yuheng-null/stm32-smart-fan/Core/Inc/main.h

#define KEY1_Pin GPIO_PIN_0
#define KEY1_GPIO_Port GPIOC
#define KEY2_Pin GPIO_PIN_1
#define KEY2_GPIO_Port GPIOC
#define FAN_TACH_Pin GPIO_PIN_1
#define FAN_TACH_GPIO_Port GPIOA
#define RELAY_IN_Pin GPIO_PIN_0
#define RELAY_IN_GPIO_Port GPIOB
#define BUZZER_IO_Pin GPIO_PIN_1
#define BUZZER_IO_GPIO_Port GPIOB
#define IR_RX_Pin GPIO_PIN_7
#define IR_RX_GPIO_Port GPIOC
#define IR_RX_EXTI_IRQn EXTI9_5_IRQn
#define FAN_PWM_Pin GPIO_PIN_8
#define FAN_PWM_GPIO_Port GPIOA
#define OLED_SCL_Pin GPIO_PIN_6
#define OLED_SCL_GPIO_Port GPIOB
#define OLED_SDA_Pin GPIO_PIN_7
#define OLED_SDA_GPIO_Port GPIOB
