yuheng-null/stm32-smart-fan/(commit log)

2026-10-10 STM32F407VET6 智能温控风扇：HAL 工程骨架与串口链路
    - CubeMX 生成的 CMake 工程（Core/ + Drivers/ + cmake/）
    - 时钟：8 MHz HSE → 168 MHz（PLLM=8 / PLLN=336 / PLLP=2 / PLLQ=7，APB1=/4，APB2=/2）
    - 调试：SWD（PA13/PA14）
    - USART1 115200-8-N-1（PA9=TX / PA10=RX），接 CH340
    - 分层骨架：interface/（契约）→ bsp/（实现）→ app/（编排）
    - 串口接收走中断 + 256 字节环形缓冲，实测连续 512 字节背靠背收发不丢
    - 配置改动走 cube-recipes/ 配方 + tools/cubemx_apply.py 驱动 CubeMX 脚本模式
    - tools/capture_serial.py：抓串口输出并测量心跳间隔（用于实测主频）
    - docs/：架构说明 + 从空文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
2026-10-11 三路外设驱动：SSD1306(软 I2C) / NTC 测温(ADC) / 按键；新增 driver 层
    ## 新增
    - driver/ 层：`bus/`（软件 I2C 位翻转实现）+ `device/`（SSD1306 驱动，
    不含任何 STM32 符号）。契约集中在 interface/（新增 i2c_if.h），
    bsp/ 只负责「这块板上谁接在哪」。
    - bsp/bsp_i2c.c PB6=SCL / PB7=SDA，开漏输出 + 上拉
    - bsp/bsp_oled.c SSD1306 绑定、0x3C/0x3D 地址探测、总线扫描
    - bsp/bsp_key.c PC0/PC1，SysTick 1 ms 采样 + 20 ms 计数式消抖
    - bsp/bsp_adc.c PA0 / ADC1_IN0
    - module/temperature/ NTC 分压 -> Beta 方程 -> 毫摄氏度。纯计算，
    不碰硬件，可脱离板子在 PC 上单测。
    - app/app_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
2026-10-11 工程工具加 regenerate 子命令；补齐文档里"生成代码"这一步
    ## 为什么
    `tools/cubemx_apply.py apply` 只改 `.ioc`、**不生成代码**，而"生成"这步此前
    只有文档里那条手写 `.mxscript` 的路子。补上之后，改配置的完整流程都在工具内：
    apply → roundtrip → regenerate
    `regenerate` 做的事：给 `Core/` 下所有 USER CODE 块拍快照（并把整个 `Core/`
    备份到临时目录）→ 跑 CubeMX 生成 → 逐块比对 → 再比对 `Core/` 下文件的**内容**。
    USER CODE 丢失/被改写、或有文件被删掉，都返回非 0 并打印备份路径。
    ## 两个坑（都写进了 walkthrough 阶段 12.4）
    第一版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
2026-10-11 三路新驱动：风扇 PWM 调速/FG 测速 + 继电器 + 蜂鸣器
    驱动
    - bsp/bsp_fan：TIM1_CH1 出 25 kHz PWM（开漏驱动，高电平靠风扇内部上拉建立），
    TIM2_CH2 输入捕获测 FG 周期。ISR 只做一次读寄存器 + 一次减法，
    单位换算与转速计算留给主上下文
    - module/fan_control：FG 周期 → 转速、占空比步进（纯计算，无硬件依赖，可在 PC 上单测）
    - bsp/bsp_relay（PB0，高电平触发）/ bsp/bsp_buzzer（PB1，低电平触发）：
    初始电平的唯一来源是 .ioc 的 PinState，驱动侧不再写第二遍
    - app：K1/K2 加减档；串口单字符命令 ? + - r b t；状态行与 OLED 加风扇/继电器/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
2026-10-11 温控业务层：级联控制 + 运行模式状态机 + 宿主机单测与 CI
    ## 新增（module/，全部纯计算，可在 PC 上单测）
    - common/ 共享值类型（采样快照、模式、报警位），只有头文件
    - fan_curve/ 温度 -> 目标转速：分段线性插值 + 施密特迟滞，整数域
    - pi_control/ 通用 PI：条件积分抗饱和 + 限幅 + 限速率，无 D 项
    - thermal_control/ 级联控制器 = fan_curve + pi_control 的组合
    （EMA 抑噪、传感器去抖、温度兜底、FG 失效切开环前馈、无扰切换）
    - fan_fsm/ 运行模式状态机（INIT/OFF/MANUAL/AUTO/DEGRADED/FAULT）
    - console/ 串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
2026-10-11 上板实测修复三处，并按实测 τ 重整定内环 PI
    烧录后跑验收，抓到三个只有硬件才能暴露的问题，外加一次整定事故。
    ## 修复
    1. !TACH 误报
    温度低于曲线起点时风扇本就该停转，FG 自然没有沿，却被判成「丢信号」，
    系统一直挂在 DEGRADED + !TACH 这个假故障上。
    改为两条前提：只有**确实要求它转**（目标转速 > 0）时缺反馈才算故障；
    且只有 ERR_TIMEOUT / ERR_UNDERFLOW 算「信号断了」的证据，
    ERR_NOT_READY（刚起转、还没凑够两个沿）与 ERR_OVERFLOW（毛刺）是瞬态，
    把它们也算进去会让风扇每次启动都凭空报一次故障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
2026-10-11 README 重写：补齐「功能与现象」，按模式/命令/报警/故障逐条写明现象
    原来的 README 讲的是「怎么编译、怎么验证」，但没讲清**这东西到底做什么、
    每种情况下会看到什么**。补上一整节，按读者会问的顺序组织：
    - 一句话说明 + 五块功能分别落在哪个模块
    - **上电后头几秒会看到什么**（含「刚烧录过会看到转速滑停」这个容易被当成
    故障的现象）
    - **六种运行模式**：每一种在 风扇/报警灯/蜂鸣器/OLED/串口 五处分别是什么现象，
    以及为什么报警灯亮在 FAULT 而不是过温（冷却风机故障应满速，不能断电）
    - **按键**：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
2026-10-11 CI：actions/checkout 升到 v5，消掉 Node 20 弃用提醒
    首次运行的输出里有 GitHub 的弃用注解（v4 目标是 Node 20，被强制跑在
    Node 24 上）。升到 v5 之后 CI 输出干净，不会让人误以为有什么问题。
2026-10-11 README 补上实测波形与可复现工具
    ## 新增「实测结果」一节
    嵌入两张**板上实测**的图（数据来自 @TEL 遥测帧，不是示意图）：
    - 阶跃辨识：MANUAL 20 → 60，按 63% 规则得 **τ ≈ 1.4 s**
    （三次独立测量 1.39 / 1.41 / 1.39 s，可复现）
    - 闭环跟踪：从 MANUAL 切进 AUTO，约 10 s 收敛；
    **稳态偏差落在一个占空比量化台阶以内**（1% duty ≈ 163 rpm，
    在 5300 rpm 上是 3%，多次实测 1.5%~2.4%）
    这两张图是整篇文档里最有说服力的部分——它们把「这套控制真的在工作」
    从文字变成了数据。
    ## 新增 tools/fan_demo.py
    一条命令重现上面两张图：自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
2026-10-11 业务层：修温度非对称去抖、EMA 陈旧值，补两条回归测试
    温度兜底的两个方向共用了进入阈值：进入要连续 3 拍无效、退出本该连续 5 拍
    有效，但退出实际在第 3 拍就发生，recovery_debounce_samples 与退出时的曲线
    迟滞复位都成了不可达代码。改为按当前认定的方向选阈值，退出挂在下沿上。
    顺带几处控制层的边界：
    - 转速无效期间清掉 EMA 标志，恢复后的第一个样本直接采信，不再把断线前的
    陈旧读数按 (1-alpha) 混进来喂给 PI
    - PI 挡住 NaN 的误差：clampf 对 NaN 会原样返回，一旦进入就永久污染状态
    - thermal_control_init 抬高 PI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
2026-10-11 应用层与 BSP：显示改走 BSP 契约，启动不再被串口门控
    分层：app_display.c 原先直接 include driver/device/ssd1306 并自己持有设备
    实例，等于把外设驱动放进了 APP 层，与 docs/architecture.md 的依赖表不符。
    改成 BSP 透出一组与器件无关的绘制接口（清屏 / 画字 / 量字宽 / 上屏），
    ssd1306_t 与显存实例都收进 bsp_oled.c；APP 层不再认识 SSD1306。
    启动：原先开机横幅发不出去就 continue，串口 TX 一出问题主循环永远停在横幅
    那一步，温控、按键、报警灯、蜂鸣器全都不工作。改成横幅只发一次、失败也不
    挡后面的任务——诊断链路坏掉不该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
2026-10-11 文档与代码对齐，并把标定内容按「能力」叙述
    与代码对不上的地方逐条改到一致：
    - docs/control.md 的曲线锚点表刷新为当前值（30C/3500 ... 60C/13500），
    并说明低端为什么从最小可控转速起步
    - 整定算式：lambda 的单位是秒。按 lambda = 2.5 s 代入才得到发布的
    0.0034 / 0.0025（反解 lambda = tau/(K*Kp) 约 2.53 s），原表把
    lambda 标成 tau 的倍数、代入的却是秒
    - docs/walkthrough.md 的波特率分频算式补成完整两步（商约 45.573，
    取整到 4 位小数的 USARTDIV = 729/16 = 45.5625）
    - 中断优先级一段改为描述实际分配：USART1 = 2、TIM2 捕获 = 3，
    并说明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
2026-10-11 红外遥控：NEC 解码模块 + EXTI 接线 + 按键表与学习模式
    接一个 VS1838B（OUT → PC7），用任意 NEC 遥控器控制风扇。
    解码做成纯计算的独立模块（module/ir_remote）：输入是「边沿 + 这个电平持续了
    多久」，输出是一帧或一次拒绝。不含 HAL、不看引脚，所以能在 PC 上用合成波形
    穷举测试（tests/test_ir_remote.c，20 个用例）。红外一次误码要在整帧 32 位里
    定位到具体哪一位，在板子上几乎做不到；合成波形既能测正常帧，也能故意把某段
    拉偏、丢一个沿、改一位，逐条核对解码器是不是按预期失败。
    解码器上有几处是刻意这么写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
2026-10-11 文档：补上红外遥控一节与接线说明
    README 增加「四、红外遥控：按键与现象」——默认键位表、按住不放的行为、
    以及换遥控器不用改代码的做法（IR LEARN 1 读码，把那行抄进 s_bindings[]）；
    后面几节顺延编号。另补上：功能块表、硬件表、串口命令表、测试表、
    上电现象与验收清单各加一条，目录结构加上 module/ir_remote。
    docs/hardware.md 补「红外接收头」一节：三针接线、引脚顺序按丝印核对
    （没有防反接，接错等于把 VCC 灌进 OUT）、为什么是解调式输出、
    为什么用 EXTI 而不是输入捕获、上拉与中断优先级的取舍，以及引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
2026-10-11 串口输出：截断时不再按 snprintf 的返回值发送
    snprintf 被截断时返回的是「本该写多长」，比缓冲区还大；原来的写法直接把它
    当成实际长度交给 app_console_send()，会读越界。判据改成「长度必须小于缓冲区
    才发」——与 app_main 里 app_send_formatted() 的判据一致。
    IR 状态那两行原来挤成一行，最坏情况会超过行缓冲，一旦截断就会整行消失；
    拆成两行之后每行都留足余量。
    （这一处是照抄 STATUS 那段的写法带进来的，说明那个写法本身就值得改。
    app_console.c 属于 app 层、不在宿主机单测覆盖范围内，所以这类问题只能靠
    代码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
2026-10-11 README：修两个错字（抄进 / 与其猜一个）
2026-10-11 仓库瘦身：CubeMX 拷进来但用不到的 CMSIS 组件不入库
    CubeMX 每次生成都会把整套 CMSIS 拷进 Drivers/CMSIS/，其中 DSP（900 多个
    文件）、神经网络库、Cortex-A 支持、调试探针固件、RTOS 头与文档都与本工程无关。
    它们占了仓库里 92% 以上的文件数。
    实测（副本实验）确认：**删文件是徒劳的**——把这几个目录删掉后再跑一次生成，
    CubeMX 会把它们原样拷回来（504 个文件 → 1576 个），于是每次改配置都会在 git
    里留下一坨一千多个文件的无用 diff。所以改成「文件留在本地、但不入库」：
    CubeMX 想拷就拷，git 不管它。
    构建真正用到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
